sandy9159/DIY-Arduino-based-2D-wire-bending-machine/BENDER-MACHINE-CIRCUIT.jpg

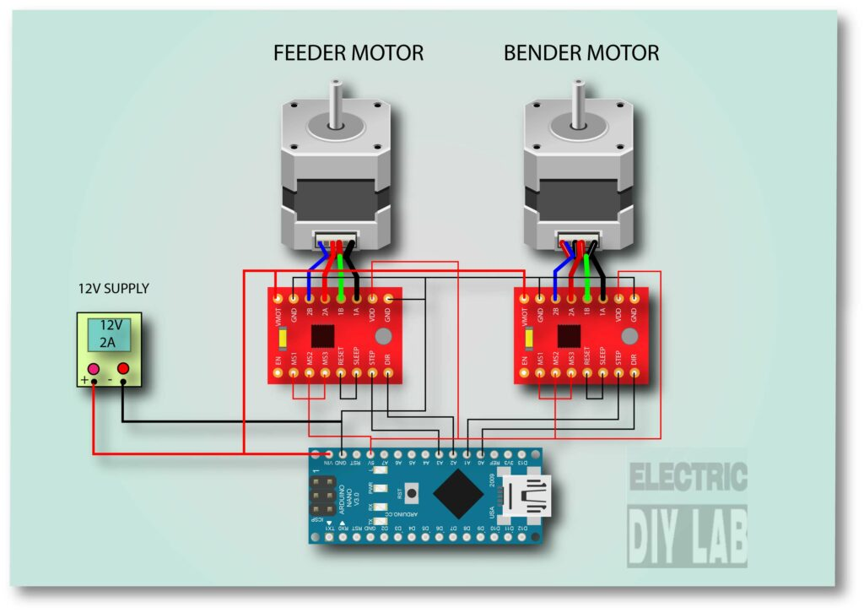
BENDER-MACHINE-CIRCUIT.jpg
